texpositor/Yacksi/KiCad/ESP-Res.kicad_sch

## KiCad design KiCad/ESP-Res.kicad_sch (2026-10-29)

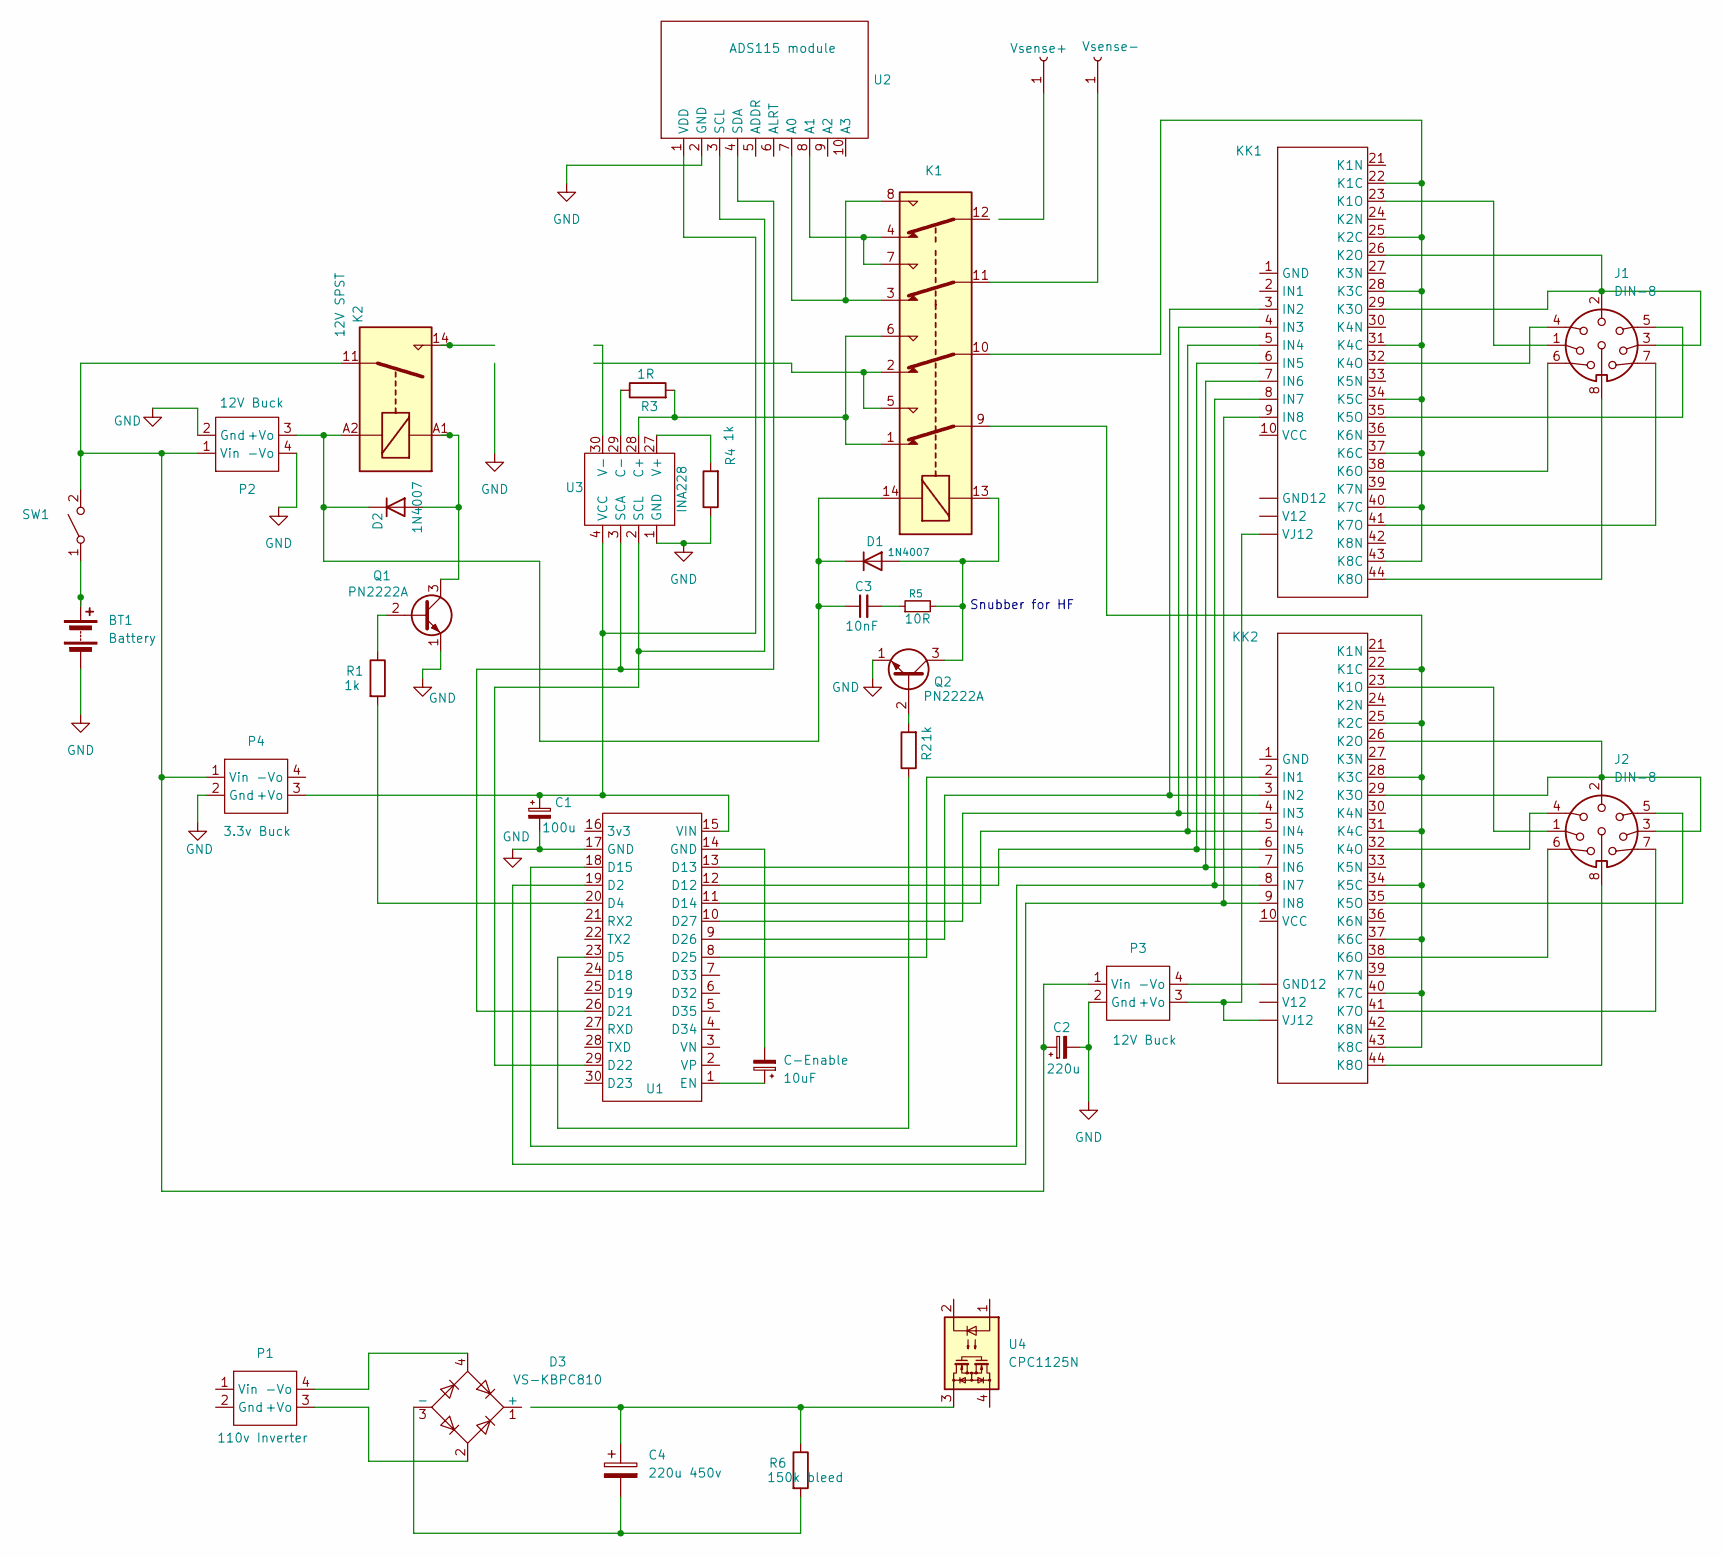
[picture p1: schematic ESP-Res.kicad_sch]

Parts:
BT1: Battery
C1: 100u
C2: 220u
C3: 10nF
C4: 220u 450v
C-Enable: 10uF
D1, D2: 1N4007; D_DO-41_SOD81_P10.16mm_Horizontal
D3: VS-KBPC810; Diode_Bridge_Vishay_KBPC6
J1, J2: DIN-8
K1: G2RL-2; Relay_DPDT_Omron_G2RL-2
K2: 12V SPST; Relay_SPST_Panasonic_ALFG_FormA_CircularHoles
KK1, KK2: (no value)
P1: 110v Inverter
P2, P3: 12V Buck
P4: 3.3v Buck
Q1, Q2: PN2222A; TO-92_Inline
R1, R2, R4: 1k
R3: 1R
R5: 10R
R6: 150k bleed
SW1: SW_SPST
U1: (no value)
U2: ADS115 module
U3: INA228
U4: CPC1125N; SOP-4_3.8x4.1mm_P2.54mm
Vsense+: Conn_01x01_Socket
Vsense-: Conn_01x01_Socket

Connections:
GND: BT1.2 (-), C1.2, C2.2, P2.2 (Gnd), P2.4 (-Vo), P3.2 (Gnd), P4.2 (Gnd), Q1.1 (E), Q2.1 (E), R4.1, U1.17 (GND), U2.2 (GND), U3.1 (GND)
unnamed: BT1.1 (+), SW1.1 (A)
unnamed: C1.1, P4.3 (+Vo), U1.15 (VIN), U2.1 (VDD), U3.4 (VCC)
unnamed: C2.1, K2.11, P2.1 (Vin), P3.1 (Vin), P4.1 (Vin), SW1.2 (B)
unnamed: C3.1, D1.1 (K), D2.1 (K), K1.14, K2.A2, P2.3 (+Vo)
unnamed: C3.2, R5.1
unnamed: C4.1, R6.1, U4.3
unnamed: C4.2, D3.3 (-), R6.2
unnamed: C-Enable.1, U1.1 (EN)
unnamed: C-Enable.2, U1.14 (GND)
unnamed: D1.2 (A), K1.13, Q2.3 (C), R5.2
unnamed: D2.2 (A), K2.A1, Q1.3 (C)
unnamed: D3.2, P1.3 (+Vo)
unnamed: D3.4, P1.4 (-Vo)
unnamed: J1.1, KK1.23 (K1O)
unnamed: J1.2, J1.3, KK1.26 (K2O), KK1.29 (K3O)
unnamed: J1.4, KK1.32 (K4O)
unnamed: J1.5, KK1.35 (K5O)
unnamed: J1.6, KK1.38 (K6O)
unnamed: J1.7, KK1.41 (K7O)
unnamed: J1.8, KK1.44 (K8O)
unnamed: J2.1, KK2.23 (K1O)
unnamed: J2.2, J2.3, KK2.26 (K2O), KK2.29 (K3O)
unnamed: J2.4, KK2.32 (K4O)
unnamed: J2.5, KK2.35 (K5O)
unnamed: J2.6, KK2.38 (K6O)
unnamed: J2.7, KK2.41 (K7O)
unnamed: J2.8, KK2.44 (K8O)
unnamed: K1.1, K1.6, R3.2, U3.28 (C+)
unnamed: K1.2, K1.5
unnamed: K1.3, K1.8, U2.7 (A0)
unnamed: K1.4, K1.7, U2.8 (A1)
unnamed: K1.9, KK2.22 (K1C), KK2.25 (K2C), KK2.28 (K3C), KK2.31 (K4C), KK2.34 (K5C), KK2.37 (K6C), KK2.40 (K7C), KK2.43 (K8C)
unnamed: K1.10, KK1.22 (K1C), KK1.25 (K2C), KK1.28 (K3C), KK1.31 (K4C), KK1.34 (K5C), KK1.37 (K6C), KK1.40 (K7C), KK1.43 (K8C)
unnamed: K1.11, Vsense-.1
unnamed: KK1.3 (IN2), KK2.3 (IN2), U1.9 (D26)
unnamed: KK1.4 (IN3), KK2.4 (IN3), U1.10 (D27)
unnamed: KK1.5 (IN4), KK2.5 (IN4), U1.11 (D14)
unnamed: KK1.6 (IN5), KK2.6 (IN5), U1.12 (D12)
unnamed: KK1.7 (IN6), KK2.7 (IN6), U1.13 (D13)
unnamed: KK1.8 (IN7), KK2.8 (IN7), U1.18 (D15)
unnamed: KK1.9 (IN8), KK2.9 (IN8), U1.19 (D2)
unnamed: KK1. (GND12), KK2. (GND12), P3.3 (+Vo)
unnamed: KK2.2 (IN1), U1.8 (D25)
unnamed: KK2. (GND12), P3.4 (-Vo)
unnamed: Q1.2 (B), R1.1
unnamed: Q2.2 (B), R2.2
unnamed: R1.2, U1.20 (D4)
unnamed: R2.1, U1.23 (D5)
unnamed: R3.1, U3.29 (C-)
unnamed: R4.2, U3.27 (V+)
unnamed: U1.26 (D21), U2.4 (SDA), U3.3 (SCA)
unnamed: U1.29 (D22), U2.3 (SCL), U3.2 (SCL)

Notes on the sheet:
Snubber for HF
