texpositor/Yacksi/KiCad/Yacsi-YetAnotherCaveSurveyInstru.kicad_sch

## KiCad design KiCad/Yacsi-YetAnotherCaveSurveyInstru.kicad_sch (2026-10-29)

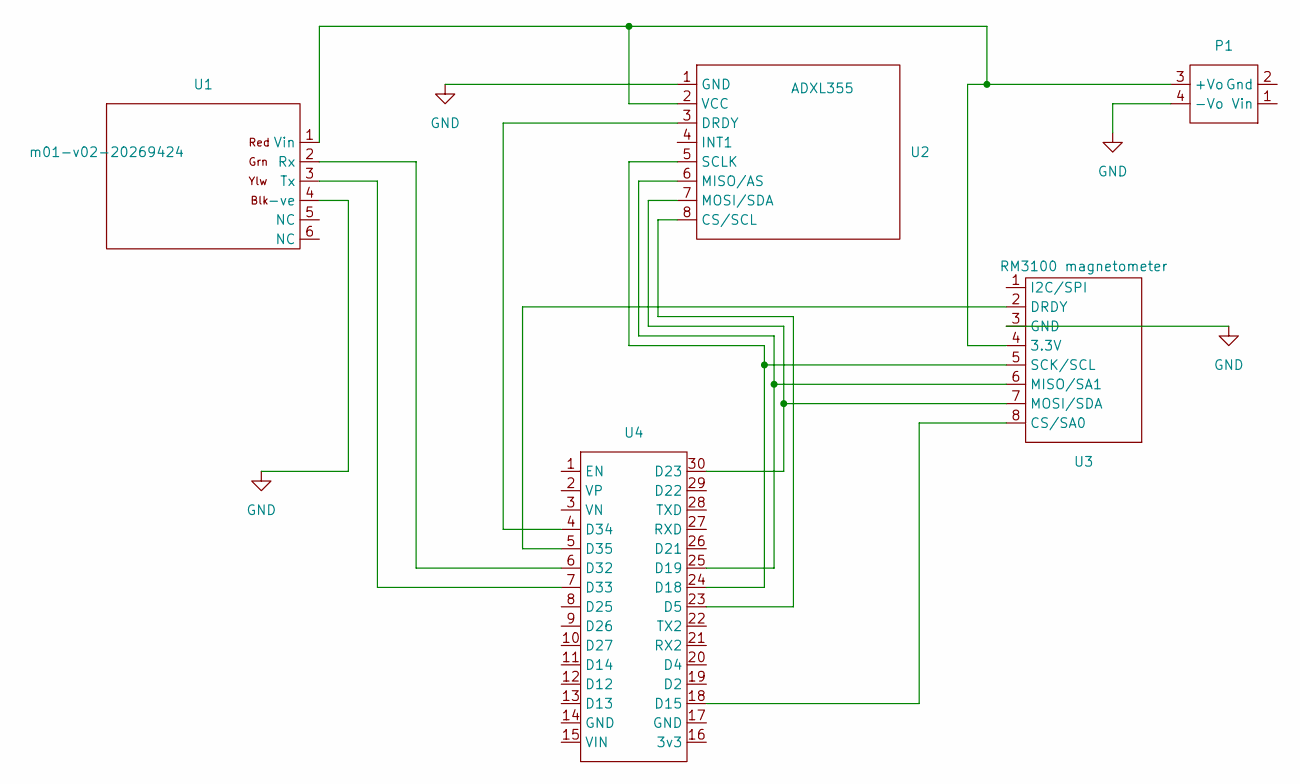
[picture p2: schematic Yacsi-YetAnotherCaveSurveyInstru.kicad_sch]

Parts:
P1: (no value)
U1: m01-v02-20269424
U2: ADXL355
U3: RM3100 magnetometer
U4: (no value)

Connections:
GND: P1.4 (-Vo), U1.4 (-ve), U2.1 (GND), U3.3 (GND)
unnamed: P1.3 (+Vo), U1.1 (Vin), U2.2 (VCC), U3.4 (3.3V)
unnamed: U1.2 (Rx), U4.6 (D32)
unnamed: U1.3 (Tx), U4.7 (D33)
unnamed: U2.3 (DRDY), U4.4 (D34)
unnamed: U2.5 (SCLK), U3.5 (SCK/SCL), U4.24 (D18)
unnamed: U2.6 (MISO/AS), U3.6 (MISO/SA1), U4.25 (D19)
unnamed: U2.7 (MOSI/SDA), U3.7 (MOSI/SDA), U4.30 (D23)
unnamed: U2.8 (CS/SCL), U4.23 (D5)
unnamed: U3.2 (DRDY), U4.5 (D35)
unnamed: U3.8 (CS/SA0), U4.18 (D15)
