texpositor/Yacksi/(commit log)

2026-10-06 Working with M01 laser, ADXL and RM3100
2026-10-06 Enhance README with M01 laser module details
    Added detailed instructions and example code for M01 laser module integration with ESP32.
2026-10-06 Clarify project status and module functionality
    Added a note about the prototype status and functionality of the project.
2026-10-07 Working if inclined about the Y axis but if the unit is on its side (y up/down) and then inclined about X the bearing is incorrect
2026-10-10 Bearings correct when the device is rotated about X and Y axes
    [main.cpp]
2026-10-12 Messing with options because calibration seems off
2026-10-17 Refactor, add magTest for RM3100 magnetometer tests, include Android code
2026-10-23 Various tweaks, now checks for data ready from the ESP32 before taking reading, still has issue with one cardinal point being well out, probably due to ADXL355 / RM3100 axes misalignment
2026-10-24 Change to Beet Heeb's calibration method, other calibration routines never achieved reasonably accurate calibration at all cardinal points
2026-10-24 Improve calibration messages, add laserTest.cpp
2026-10-25 Added button and buzzer to ESP, added Survey, stations LRUD etc to Android app
2026-10-29 Add Schematic, various Android App changes including voice control and clearing screen space
2026-10-29 Add the correct schematic files
